soutiuking/Door-lock-upgrade/(list of files, cad)

Other CAD files:
versions/v0.2/doorup.stp
