soutiuking/Door-lock-upgrade/v0.1/CHANGELOG.md

# 更新记录

## v0.1 — 2026-10-03

- 内测第一版（0.x 内测阶段）。
- 纳入 ESP-01S AP Wi-Fi 门锁固件、嵌入式网页界面和前端页面源码。
- 纳入 EPro 电路/硬件工程文件。
- 建立仓库级版本管理、README、MIT 开源协议和安全使用说明。
- 已知状态：源码目录中保留了原始工程文件；本次未宣称 Arduino 编译验证通过。首次发布前建议在目标 ESP8266 Arduino Core 环境中重新编译并在台架上测试。
