soutiuking/Door-lock-upgrade/CHANGELOG.md

# 更新记录

## v0.2 工程补全 — 2026-10-18

- v0.2 源码、完整 STVD 工程、链接配置、构建脚本及测试纳入 Git；排除编译产物和本机 IDE 状态，VERSION 更新为 v0.2。
- 补充 v0.1 README、原理结构图、开锁流程和 Wi-Fi 策略说明，根目录提供两个版本的导航。

- 补建 doorup.stw、doorup.stp，配置 STM8L051F3、STM8 Cosmic、Debug/Release、源码/头文件与 S19 生成步骤，保留自定义链接文件。
- 新增 build_cosmic.ps1，当前 PC4 恒高测试代码已用本机 Cosmic 完成两种配置的编译、链接及 ELF/S19 生成；STVD 4.3.12 内 Debug、Release 构建均为 0 错误、0 警告。

## v0.2 — 2026-10-17

- 临时诊断：默认启用 FORCE_PC4_HIGH_TEST=1，PC4 初始化后推挽恒高，CPU持续RUN，无模式检测、敲门、定时器或睡眠；设为0可恢复正常模式。

- 模式锁定：上电 PC4 保持低，TIM4 等待 50 ms 后仅采样一次 PB0，锁定至复位；删除运行时模式检测和 PB0 中断。测试模式关闭 TIM4 并 HALT，保持 PC4 静态高。
- 新增系统原理结构图、状态图、测点与供电排查说明，更新根目录与 v0.2 README。
- 用户确认修正前 Cosmic Debug 编译/链接/S19 生成通过，0 错误、0 警告；本次修正通过主机回归，需要重新目标编译和实板验证。

- STM8L051F3：PC1 上升沿，首次起算 10 秒内三次敲门，间隔至少 1 秒，低电平稳定确认 30 ms。
- PC4 成功后供电 60 秒，不续期；PB0 高电平测试常供电，低电平执行敲门流程。
- STM8 主频 2 MHz，等待时关闭定时器并进入 HALT，保留 SWIM/NRST，关闭未用外设时钟并处理闲置 GPIO。
- ESP8266 上电开启 Wi-Fi，移除定时/时段启停及页面选项；保留密码、舵机、存储和时间同步逻辑。
- v0.1 保持归档，v0.2 提供独立源码、说明及主机测试。
- 验证：ESP8266 Core 3.1.1 generic 编译、主机状态机/模拟寄存器及网页回归检查通过。STM8 本次修正的 Cosmic 目标编译、供电稳定性和功耗仍待实板验证。

## v0.1 — 2026-10-03

- 内测第一版（0.x 内测阶段）。
- 纳入 ESP-01S AP Wi-Fi 门锁固件、嵌入式网页界面和前端页面源码。
- 纳入 EPro 电路/硬件工程文件。
- 建立仓库级版本管理、README、MIT 开源协议和安全使用说明。
- 已知状态：源码目录中保留了原始工程文件；本次未宣称 Arduino 编译验证通过。首次发布前建议在目标 ESP8266 Arduino Core 环境中重新编译并在台架上测试。
