soutiuking/Door-lock-upgrade/(commit log)

2026-10-03 Update README.md
    进行部分readme的修改
2026-10-03 southing
    保证文件的好看性
2026-10-03 southing
    优化github网页端显示
2026-10-03 southing
    修改文件的格式
2026-10-03 修改一些文档问题
    111
2026-10-17 southing
    修改为使用版
